AlSpudnik/Spudnik-Drive-mk-III/LTS_Spudnik_Drive_Mk3.asc

C1: polcap; 22µ; V=8 Irms=4.08248 Rser=0.015 Lser=0
C2: cap; 270p
C3: cap; 2.2n; V=450
C4: polcap; 22µ; V=45 Irms=6.7082 Rser=0.005 Lser=0
C5: cap; 33n
C6: polcap; 47µ; V=450 Irms=3.72678 Rser=0.018 Lser=0
C7: polcap; 47µ; V=450 Irms=3.72678 Rser=0.018 Lser=0
C8: polcap; 22µ
C9: cap; 10n
C11: cap; 100n
C12: cap; 270p
C14: cap; 2.2n
C15: cap; 150p
C16: cap; 100n
C17: cap; 47n
C18: cap; 33n
R1: res; 1.5k
R2: res; 100k
R3: res; 1Meg
R4: res; 4.7k
R5: res; 500k
R6: res; 470k
R7: res; 100k
R8: res; 820
R9: res; 500k
R10: res; 30k
R11: res; 100k
R12: res; 82k
R13: res; 1k
R14: res; 8.2k
R15: res; 500k
R16: res; 6.8k
R17: res; 100k
R18: res; 15k
R19: res; 30k
R20: res; 500k
R21: res; 15k
R22: res; 1Meg
R23: res; 2.2Meg
R25: res; 100k
R27: res; 330k
R28: res; 70k
R29: res; 10k
R30: res; 120k
R32: res; 12k
R33: res; 22k
R34: res; 70k
R35: res; 180k
R37: res; 100k
R38: res; 15k
U1: triode_dd
U2: triode_dd
U3: triode_dd
U4: triode_dd
V1: voltage; SINE(0 50mV 900); AC 0.05
V2: voltage; 238v
Named nets: 0, out
.tran 0 10m 0
;ac dec 100m 10Hz 20kHz
