AlSpudnik/Spudnik-Drive-mk-III/(list of files, drawings)

Other design files:
schem_sd_mk3.dsn
