AlSpudnik/Spudnik-Drive-mk-III/(commit log)

2026-07-26 Update vintage tube reference in README
2026-07-26 Clarify tube compatibility in README
    Updated the list of compatible tubes in the README.
2026-07-26 Correct MLT and BC series resistor references
2026-07-26 Add capacitor specifications to README
2026-07-26 Update capacitor values and add new components
2026-09-17 Increase schematic image width to 900px
    Updated image size for schematic in README.
